shivashankar089/traffic-signal-controller/docs/screenshots/05_openlane_stage_by_stage/README.md

# OpenLane: Stage-by-Stage

This section follows the OpenLane implementation run from configuration through routing. The captures are from an interactive run using OpenLane v0.21 and the Sky130A PDK. The design configuration is tracked in [`physical_design/config.json`](../../../physical_design/config.json); the project's final signoff evidence is collected separately in [`06_signoff_and_gds/`](../06_signoff_and_gds/).

## Images

### Configuration and synthesis

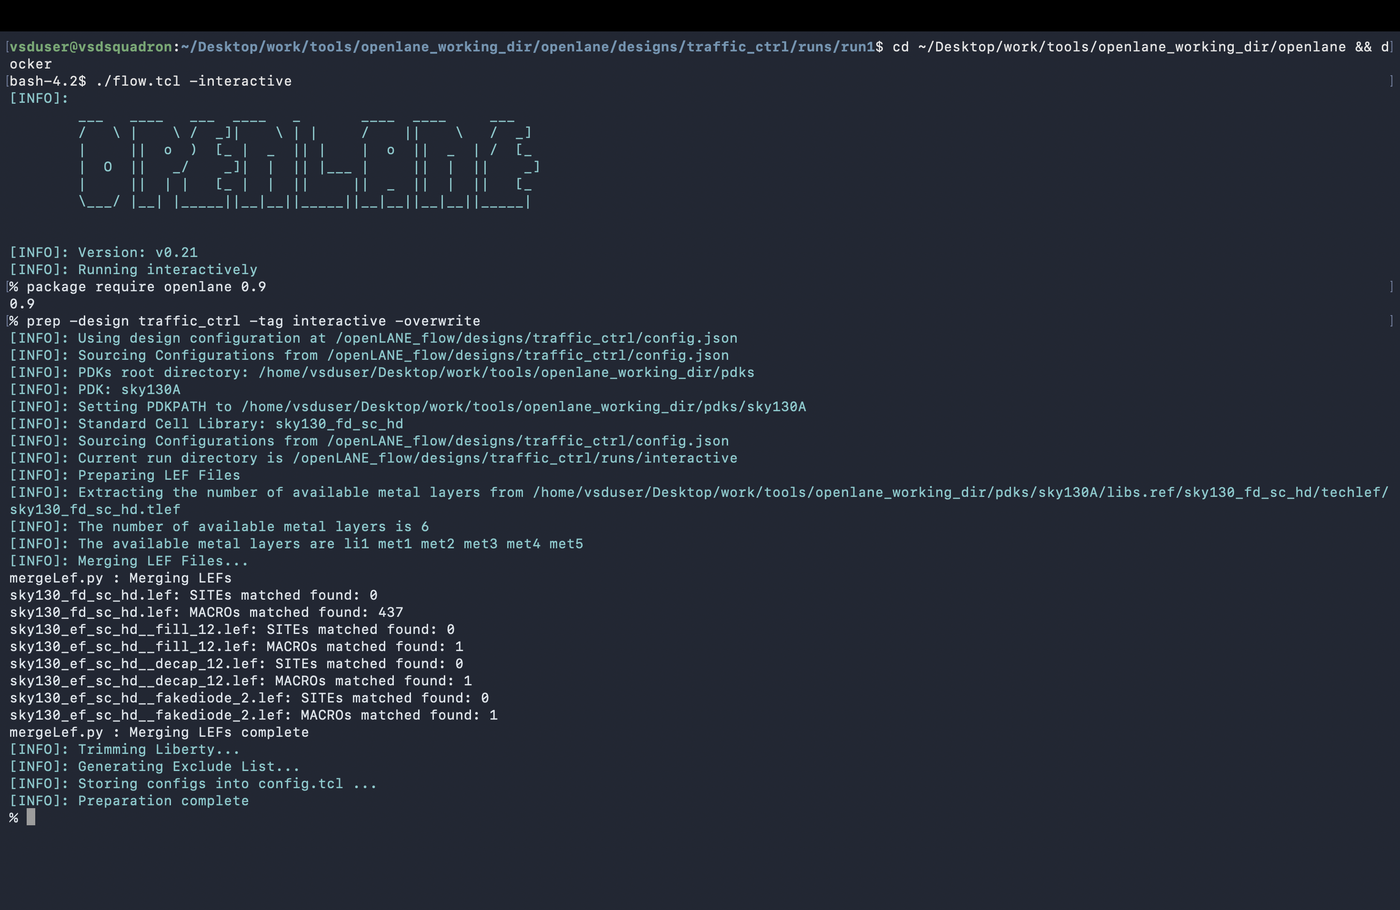
[picture p11: docs/screenshots/05_openlane_stage_by_stage/00_openlane_configuration.png]
OpenLane configuration and environment preparation


[`00_openlane_configuration.png`](00_openlane_configuration.png) shows OpenLane loading the `traffic_ctrl` configuration and preparing the Sky130 HD standard-cell library.

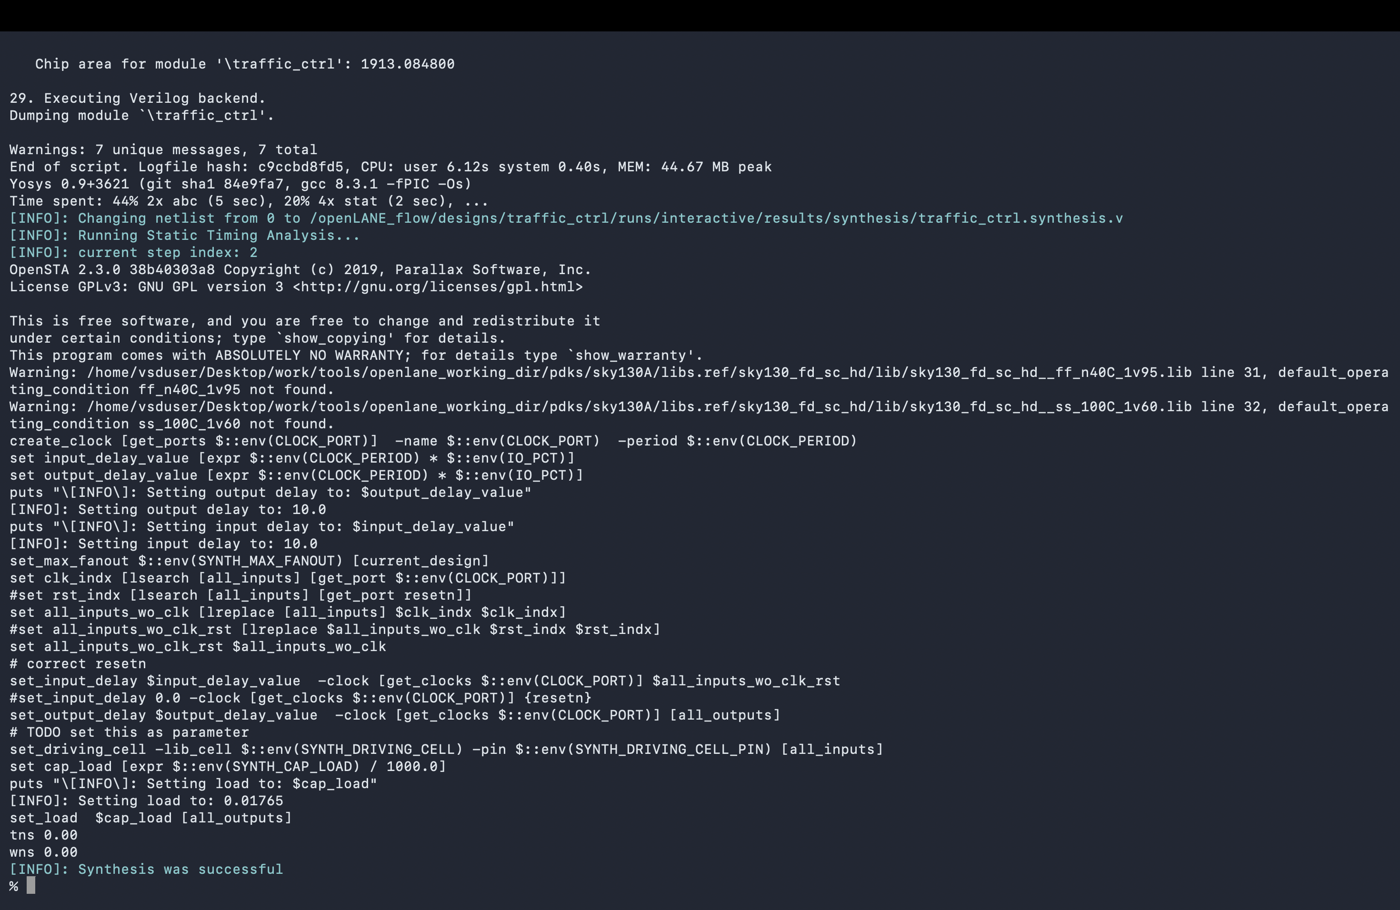
[picture p12: docs/screenshots/05_openlane_stage_by_stage/01_synthesis_successful.png]
Synthesis stage completed


[`01_synthesis_successful.png`](01_synthesis_successful.png) records successful completion of the synthesis stage.

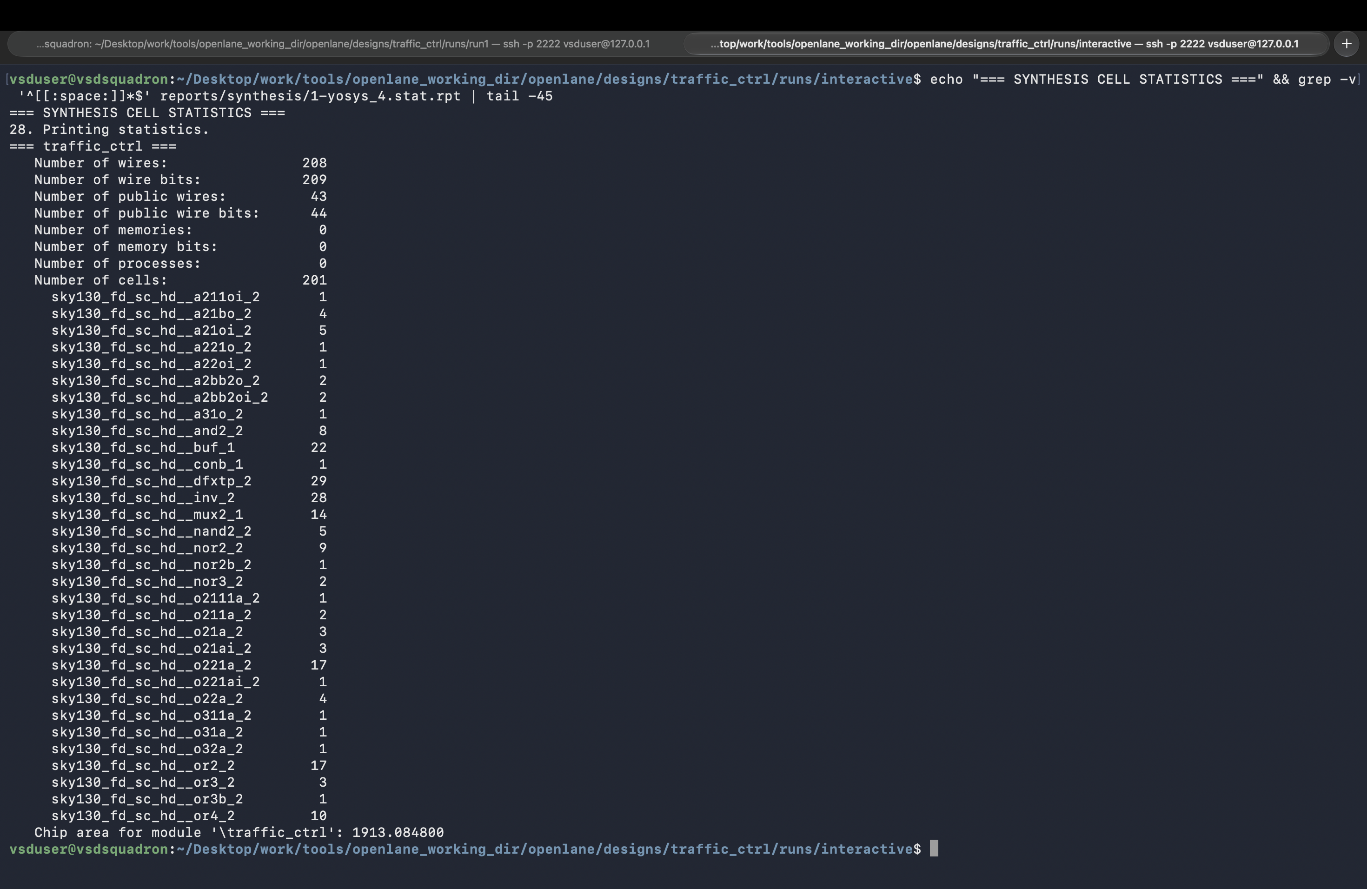
[picture p13: docs/screenshots/05_openlane_stage_by_stage/02_synthesis_stat_report.png]
Synthesis statistics


[`02_synthesis_stat_report.png`](02_synthesis_stat_report.png) shows the synthesis statistics report.

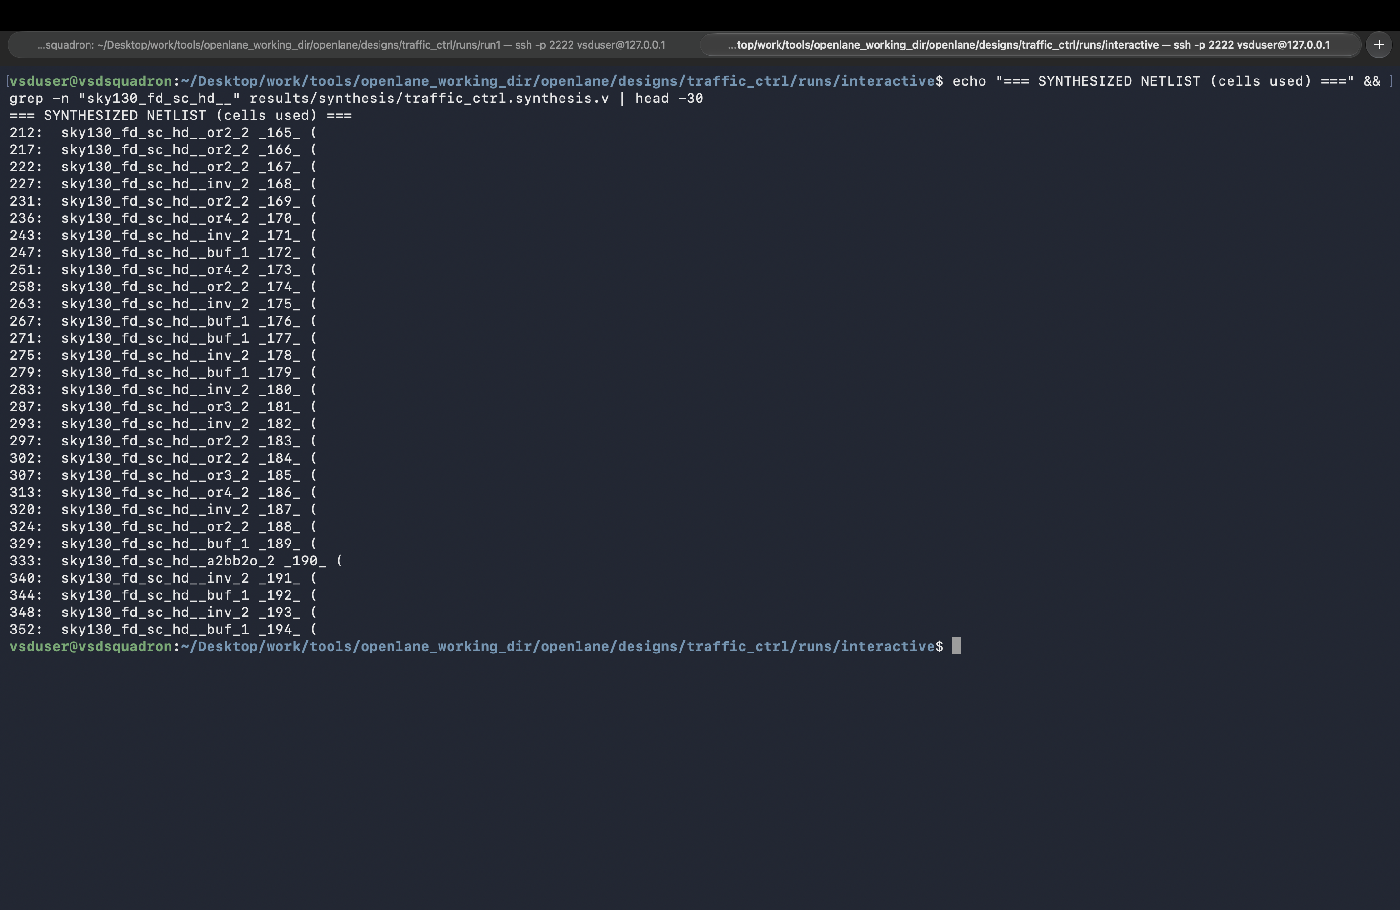
[picture p14: docs/screenshots/05_openlane_stage_by_stage/03_synthesis_netlist.png]
Synthesized netlist output


[`03_synthesis_netlist.png`](03_synthesis_netlist.png) shows the generated synthesis netlist artifact.

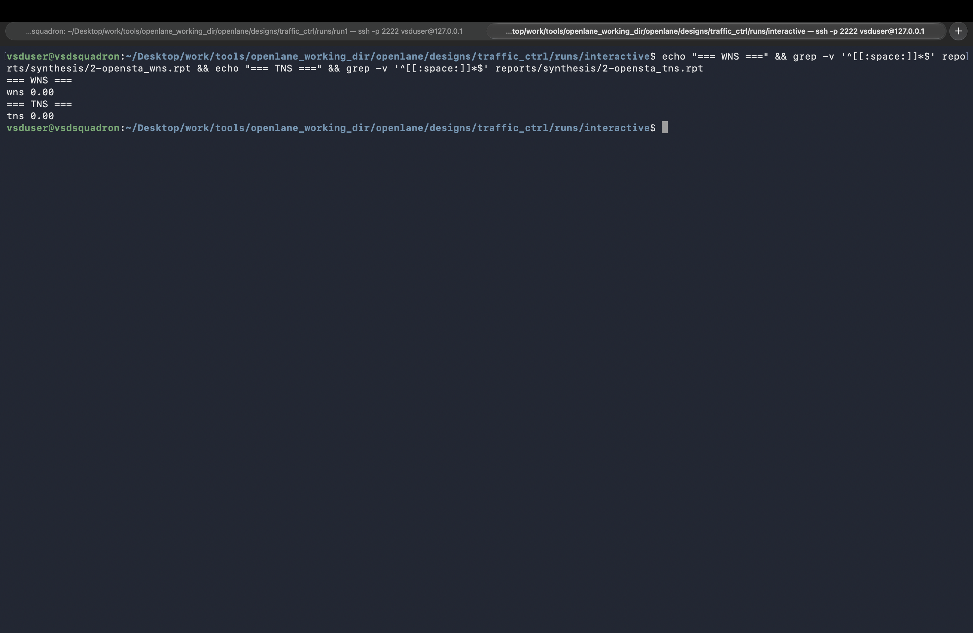
[picture p15: docs/screenshots/05_openlane_stage_by_stage/04_synthesis_sta.png]
Synthesis timing report


[`04_synthesis_sta.png`](04_synthesis_sta.png) shows timing analysis at the synthesis stage.

### Floorplanning

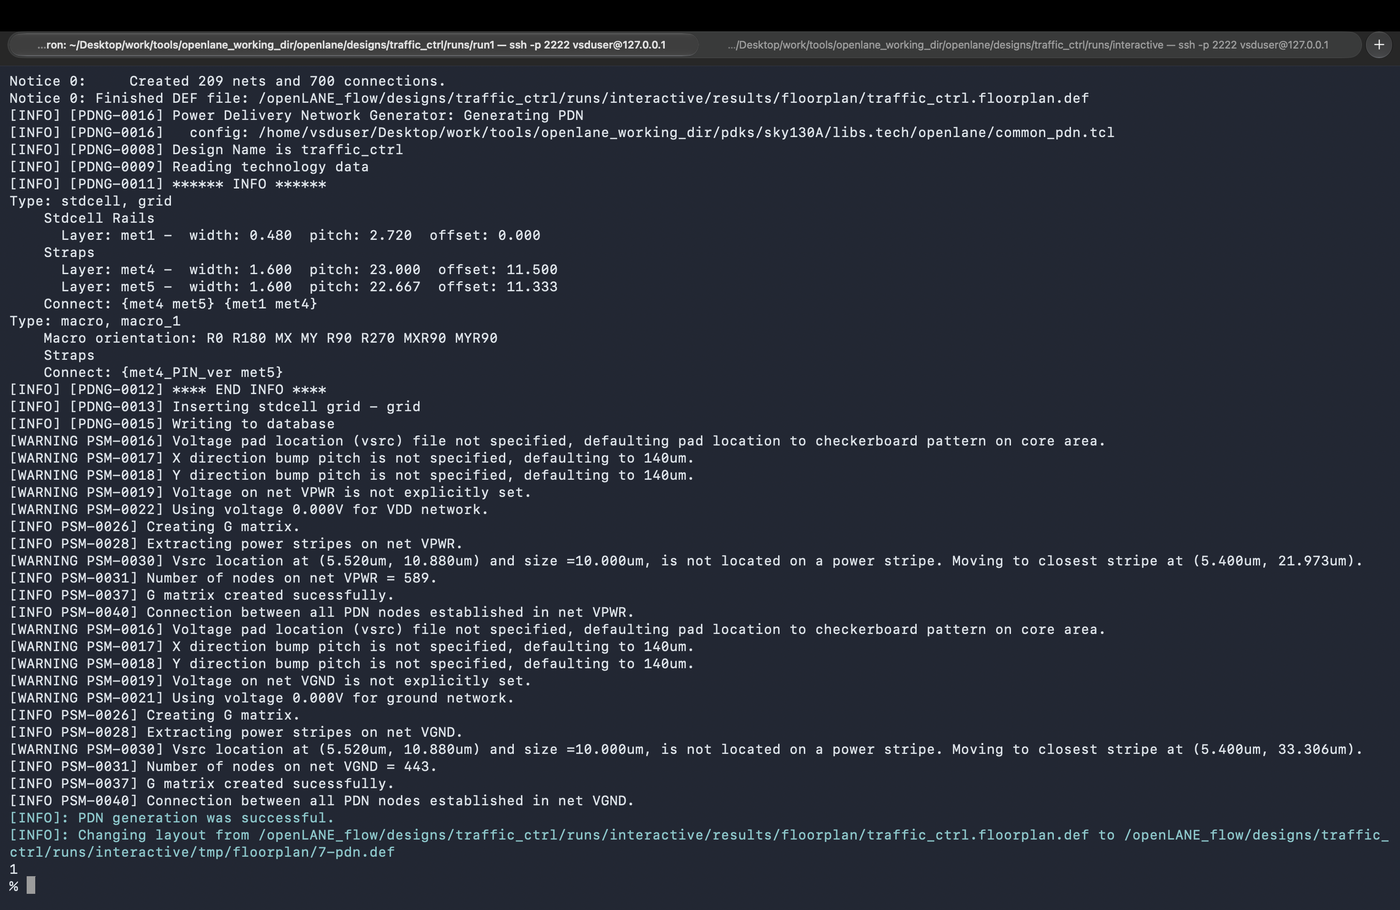
[picture p16: docs/screenshots/05_openlane_stage_by_stage/05_floorplan_successful.png]
Floorplan stage completed


[`05_floorplan_successful.png`](05_floorplan_successful.png) records successful floorplanning.

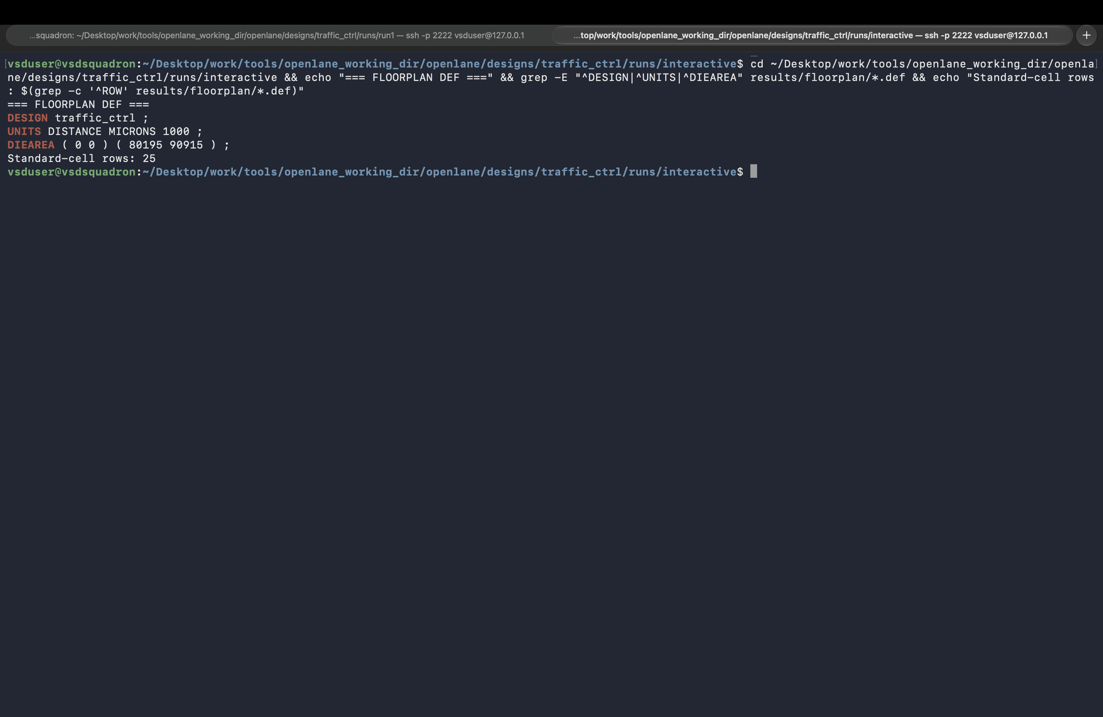
[picture p17: docs/screenshots/05_openlane_stage_by_stage/06_floorplan_def.png]
Floorplan DEF


[`06_floorplan_def.png`](06_floorplan_def.png) shows the floorplan represented in DEF.

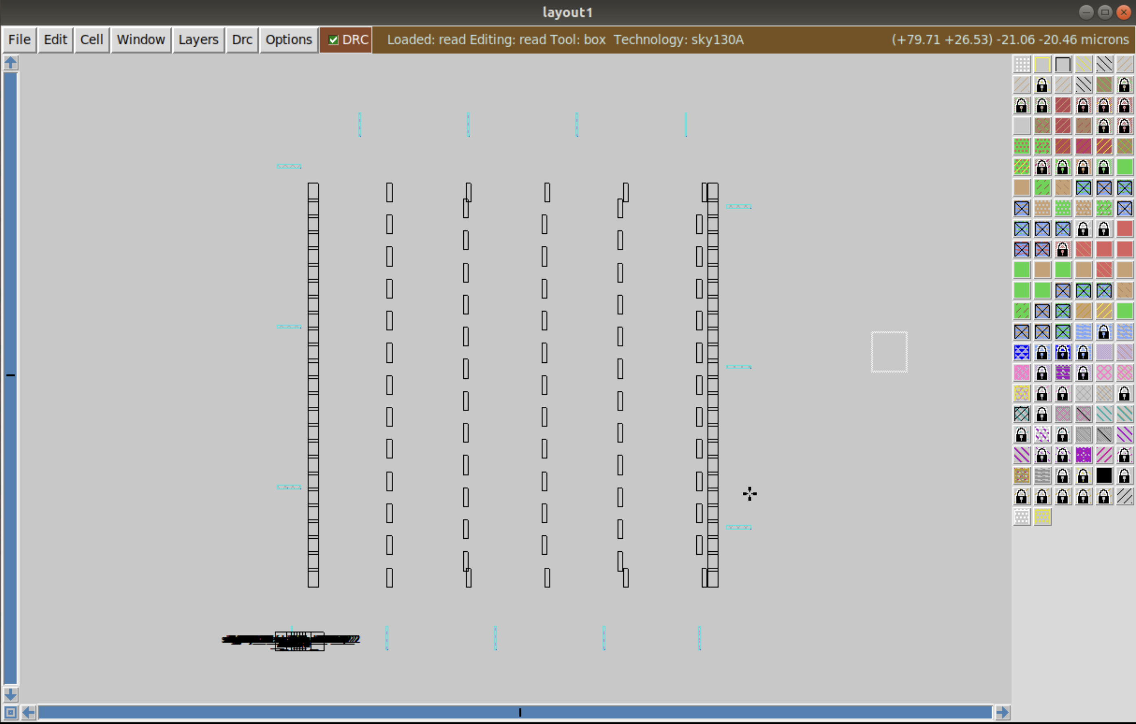
[picture p18: docs/screenshots/05_openlane_stage_by_stage/07_floorplan_magic.png]
Floorplan viewed in Magic


[`07_floorplan_magic.png`](07_floorplan_magic.png) shows the floorplan in the Magic layout viewer.

### Placement

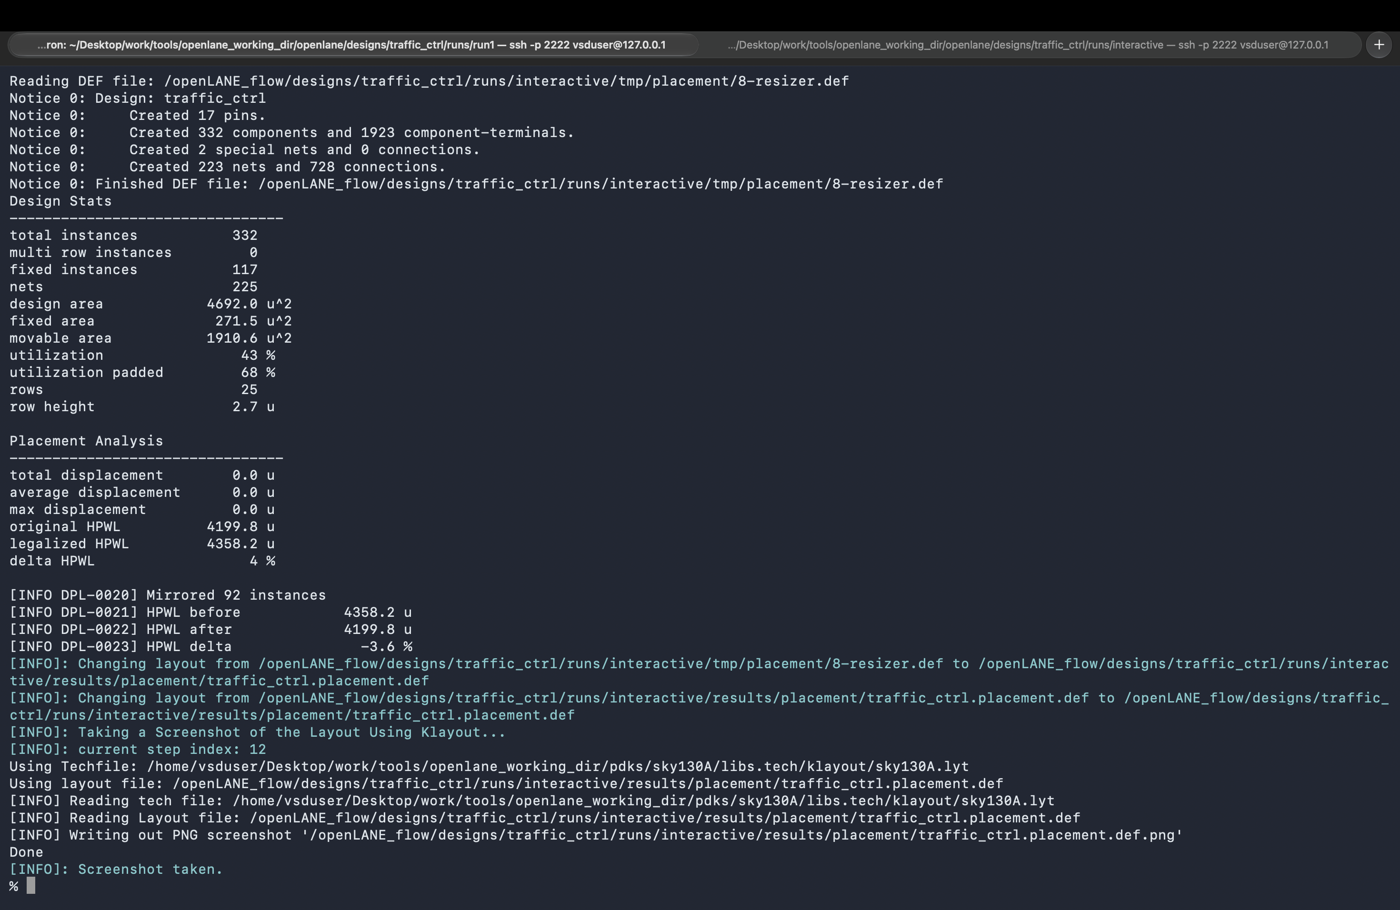
[picture p19: docs/screenshots/05_openlane_stage_by_stage/08_placement_completed.png]
Placement completed


[`08_placement_completed.png`](08_placement_completed.png) records completion of standard-cell placement.

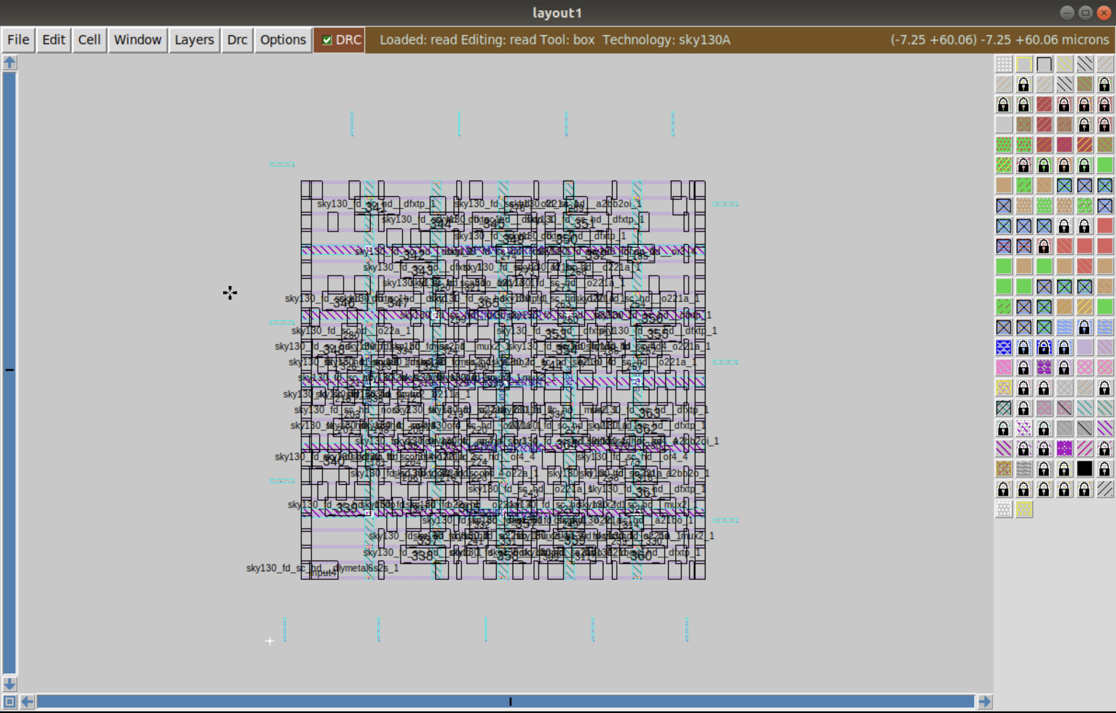
[picture p20: docs/screenshots/05_openlane_stage_by_stage/09_placement_magic.png]
Placed layout viewed in Magic


[`09_placement_magic.png`](09_placement_magic.png) shows the placed design in Magic.

### Clock-tree synthesis

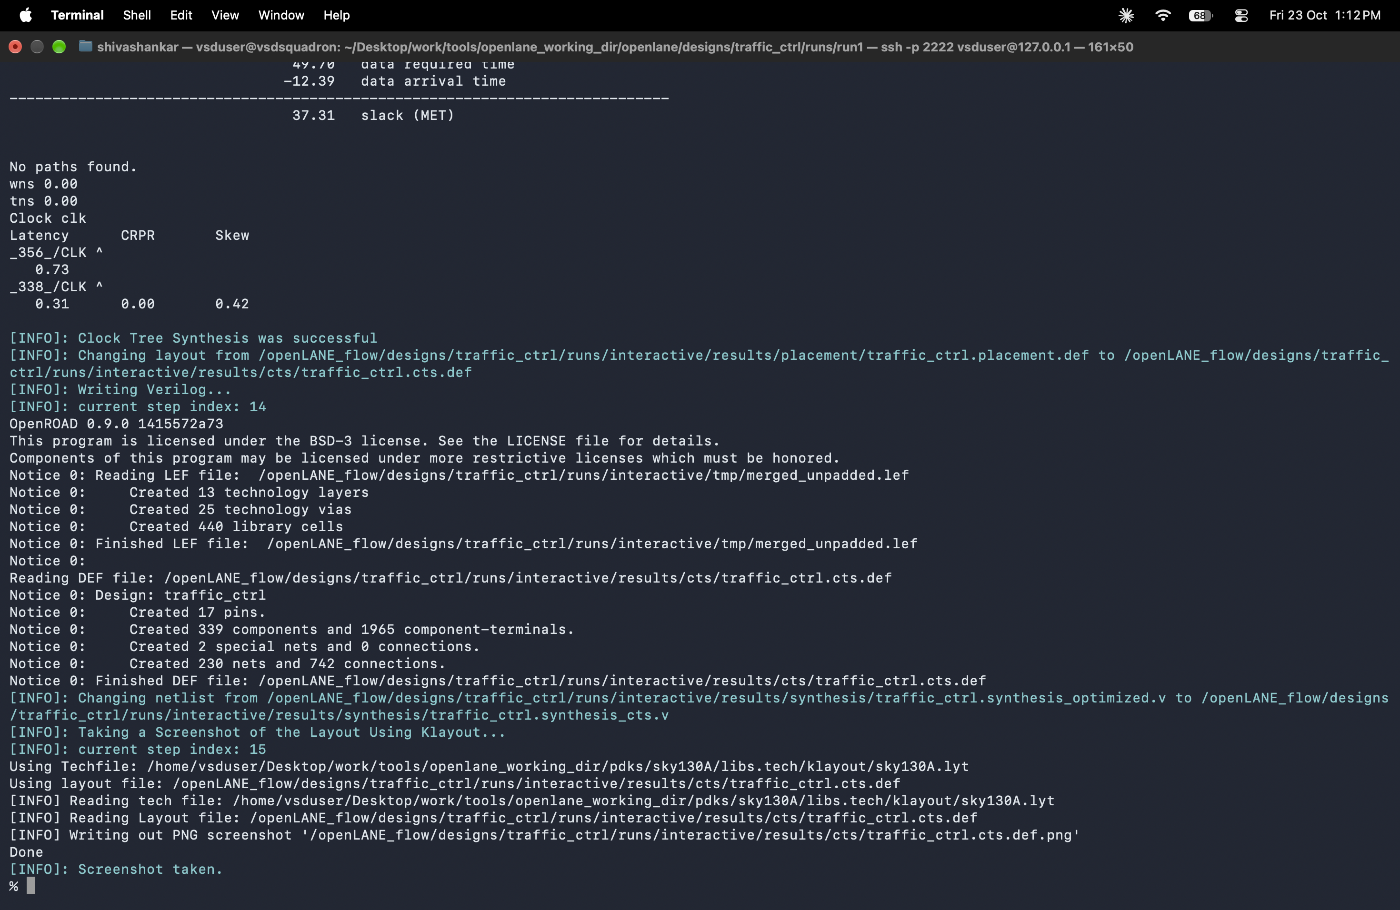
[picture p21: docs/screenshots/05_openlane_stage_by_stage/10_cts_run_successful.png]
Clock-tree synthesis completed


[`10_cts_run_successful.png`](10_cts_run_successful.png) records successful completion of clock-tree synthesis (CTS).

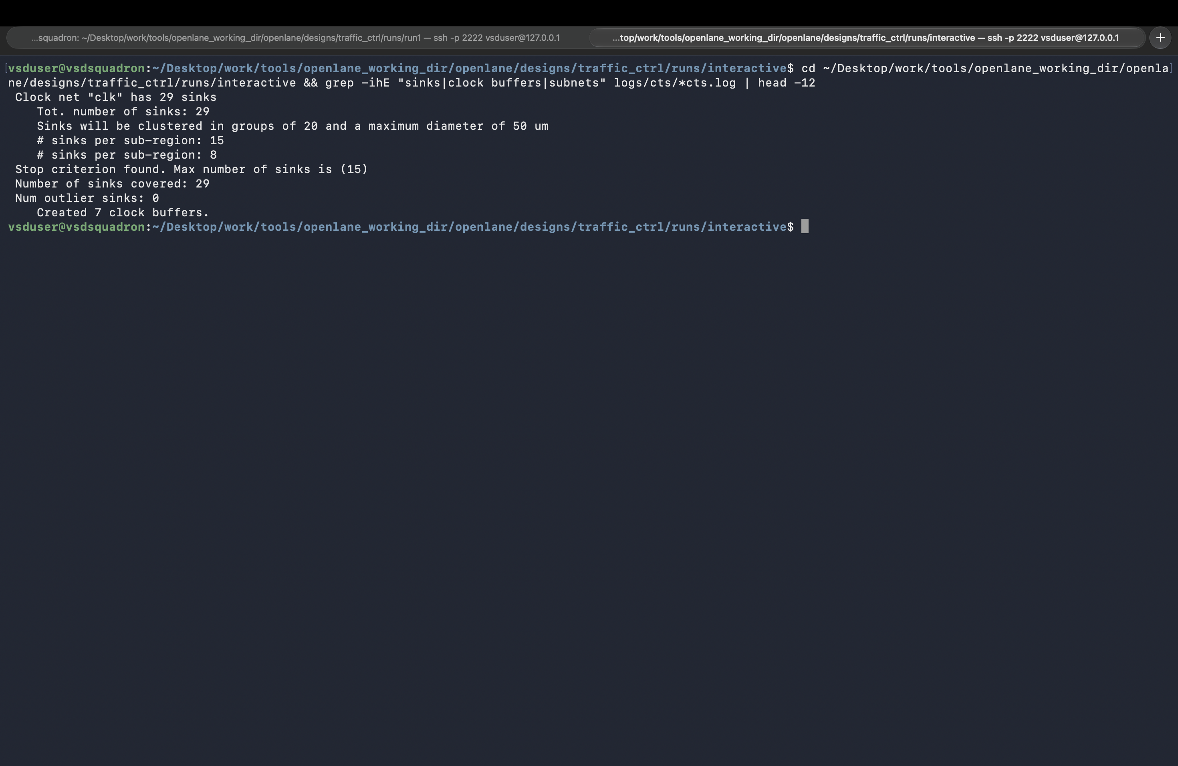
[picture p22: docs/screenshots/05_openlane_stage_by_stage/11_cts_stats.png]
Clock-tree synthesis statistics


[`11_cts_stats.png`](11_cts_stats.png) shows CTS-related statistics.

### Routing

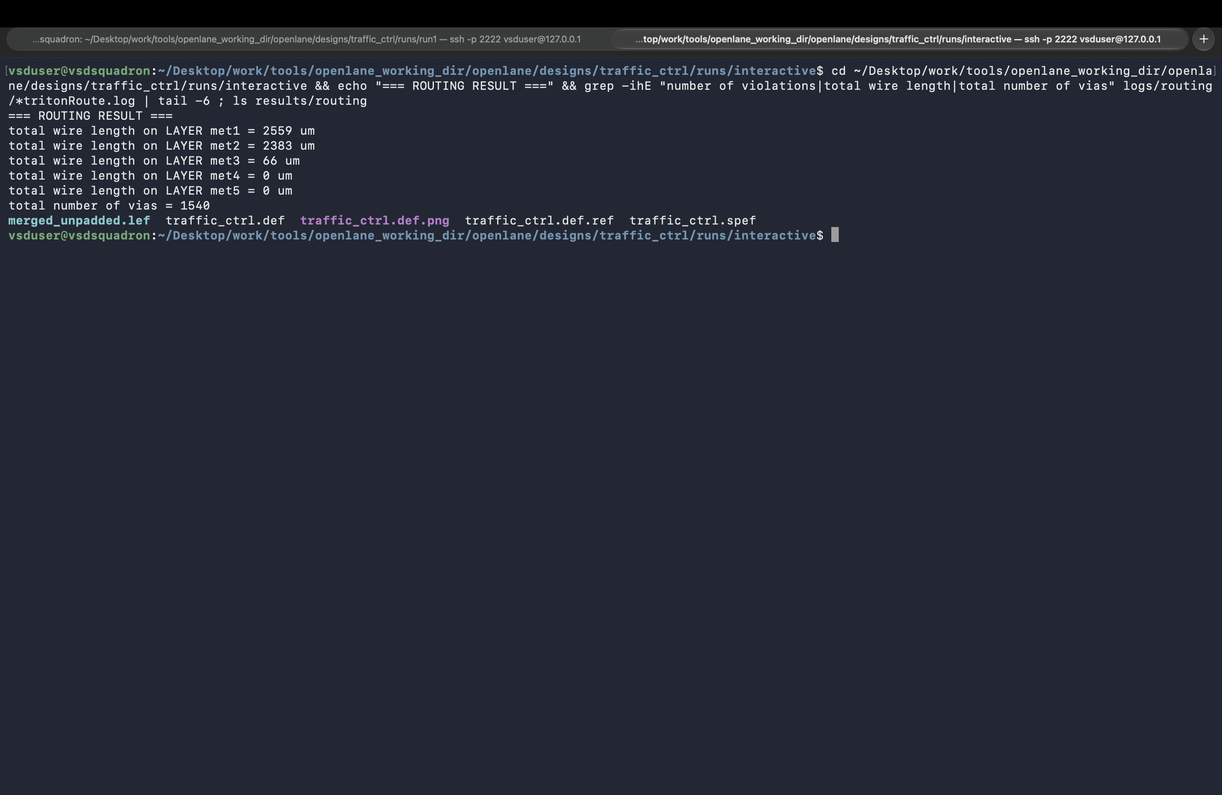
[picture p23: docs/screenshots/05_openlane_stage_by_stage/12_routing_successful.png]
Routing completed


[`12_routing_successful.png`](12_routing_successful.png) records successful completion of routing.

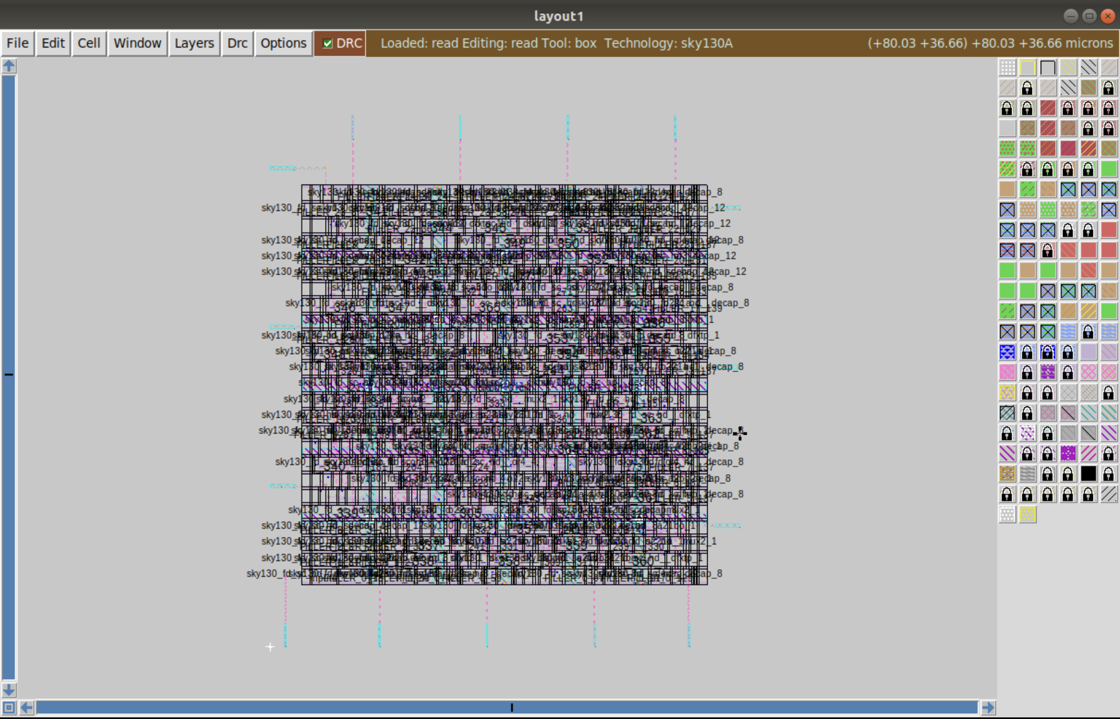
[picture p24: docs/screenshots/05_openlane_stage_by_stage/13_routing_magic_layout.png]
Routed layout viewed in Magic


[`13_routing_magic_layout.png`](13_routing_magic_layout.png) shows the routed layout in Magic.

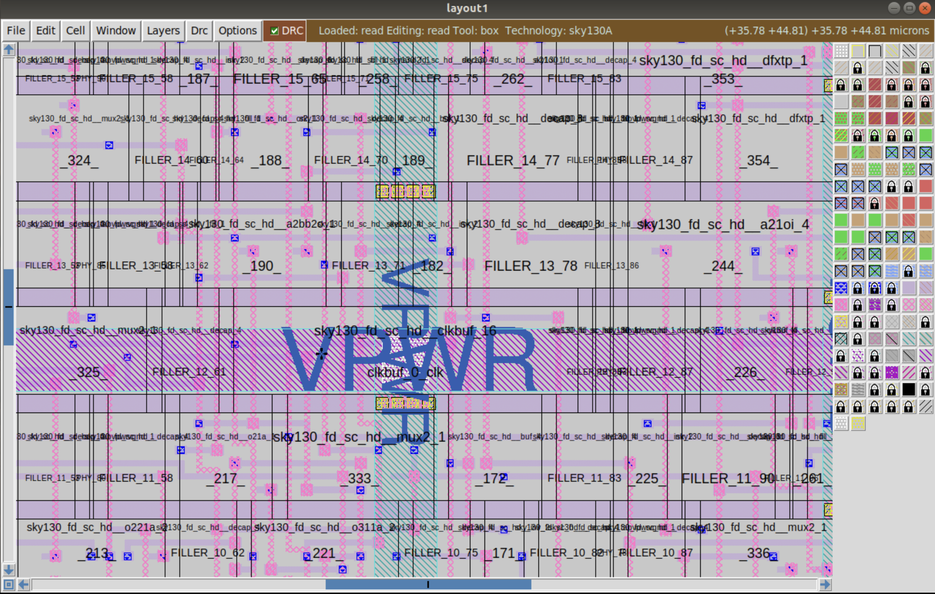
[picture p25: docs/screenshots/05_openlane_stage_by_stage/14_routing_magic_layout_zoom.png]
Zoomed routed layout


[`14_routing_magic_layout_zoom.png`](14_routing_magic_layout_zoom.png) provides a closer view of the routed layout.

## Scope

These images document intermediate stages, rather than serving as a complete signoff report. For the final GDS, DRC, LVS, antenna, area, and timing evidence, see [`06_signoff_and_gds/`](../06_signoff_and_gds/).
