shivashankar089/traffic-signal-controller/physical_design/reports/layout_pictures/traffic_ctrl.cts.def.png

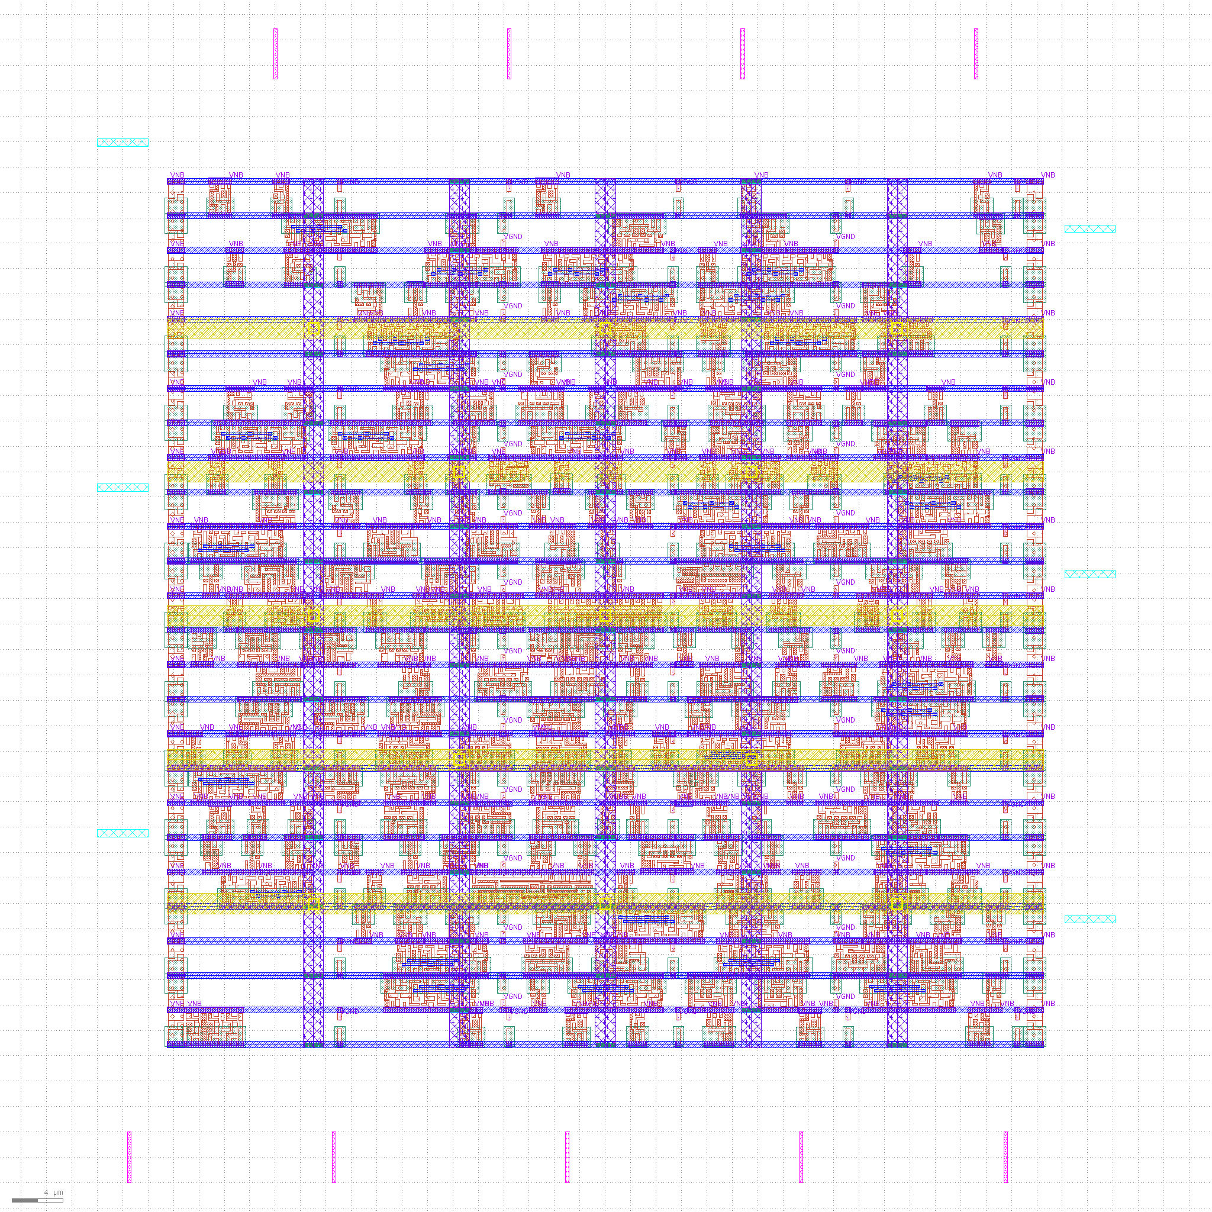
physical_design/reports/layout_pictures/traffic_ctrl.cts.def.png
