shivashankar089/traffic-signal-controller/physical_design/reports/layout_pictures/traffic_ctrl.floorplan.def.png

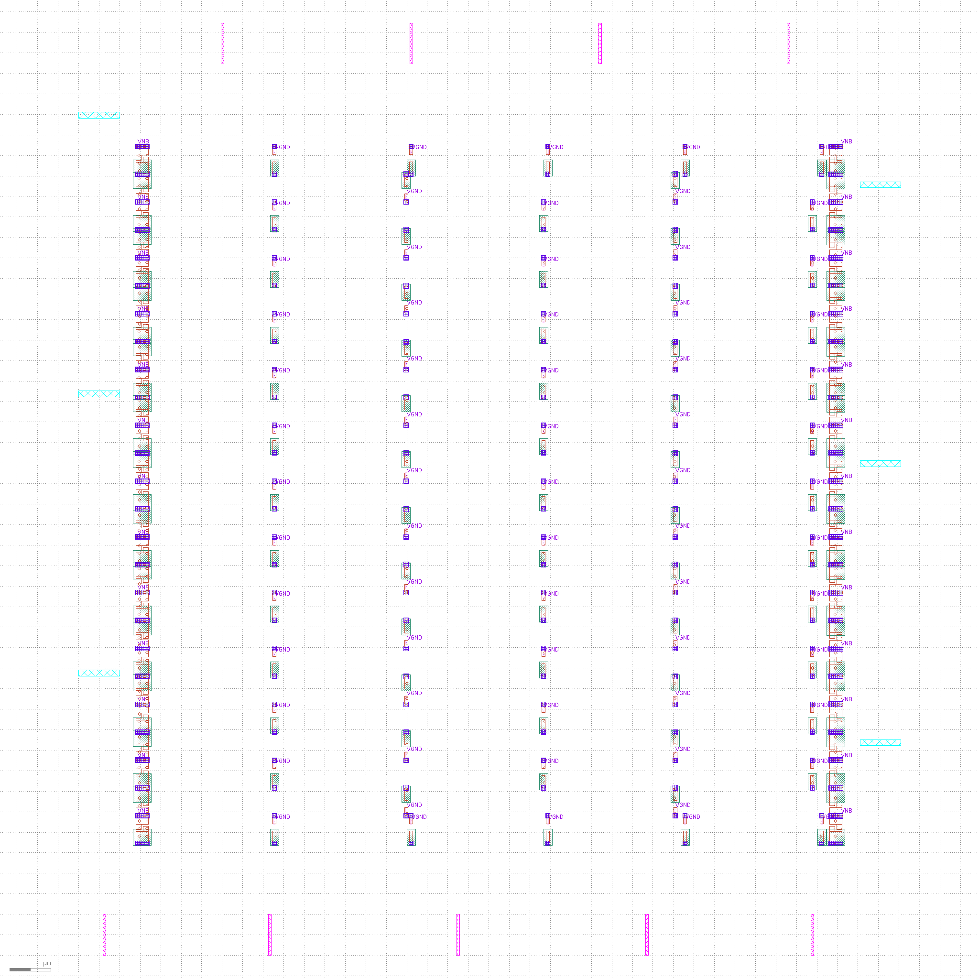
physical_design/reports/layout_pictures/traffic_ctrl.floorplan.def.png
