shivashankar089/traffic-signal-controller/physical_design/reports/layout_pictures/traffic_ctrl.gds.png

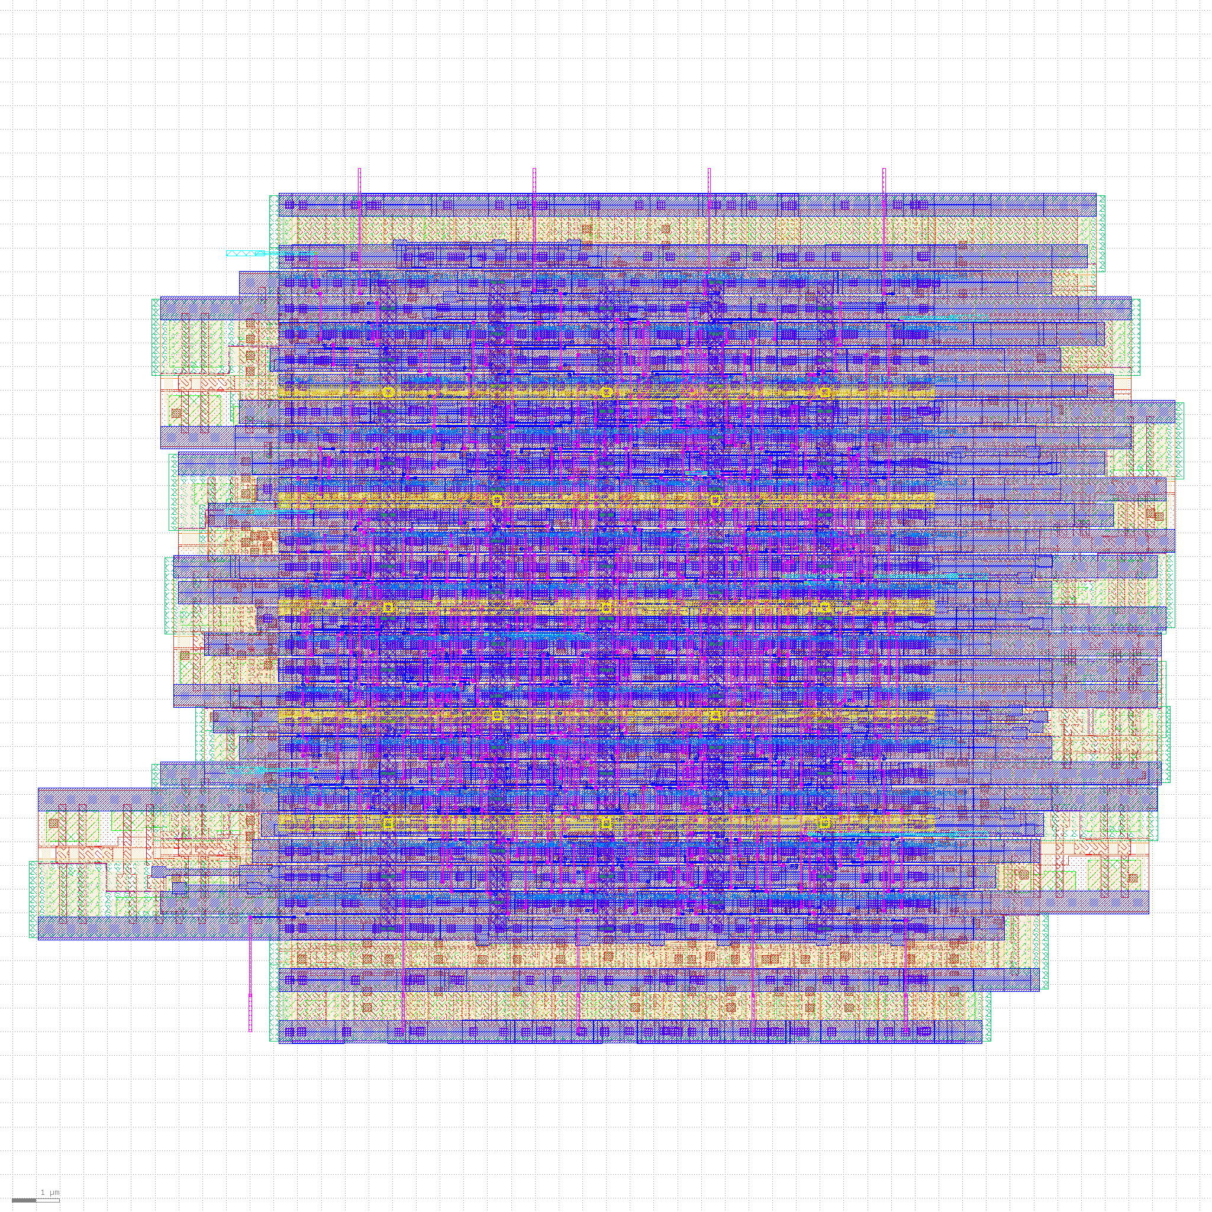
physical_design/reports/layout_pictures/traffic_ctrl.gds.png
