shivashankar089/traffic-signal-controller/physical_design/reports/summary/final_summary_report.csv

 | design | design_name | config | flow_status | total_runtime | routed_runtime | (Cell/mm^2)/Core_Util | DIEAREA_mm^2 | CellPer_mm^2 | OpenDP_Util | Peak_Memory_Usage_MB | cell_count | tritonRoute_violations | Short_violations | MetSpc_violations | OffGrid_violations | MinHole_violations | Other_violations | Magic_violations | antenna_violations | lvs_total_errors | cvc_total_errors | klayout_violations | wire_length | vias | wns | pl_wns | optimized_wns | fastroute_wns | spef_wns | tns | pl_tns | optimized_tns | fastroute_tns | spef_tns | HPWL | routing_layer1_pct | routing_layer2_pct | routing_layer3_pct | routing_layer4_pct | routing_layer5_pct | routing_layer6_pct | wires_count | wire_bits | public_wires_count | public_wire_bits | memories_count | memory_bits | processes_count | cells_pre_abc | AND | DFF | NAND | NOR | OR | XOR | XNOR | MUX | inputs
0 | /openLANE_flow/designs/traffic_ctrl | traffic_ctrl | run1 | Flow_completed | 0h19m22s | 0h17m45s | 69791.66666666667 | 0.0072 | 27916.66666666667 | 43 | 416.66 | 201 | 0 | 0 | 0 | 0 | 0 | 0 | 0 | 0 | 0 | 0 | -1 | 5265 | 1547 | 0.0 | 0.0 | 0.0 | 0.0 | 0.0 | 0.0 | 0.0 | 0.0 | 0.0 | 0.0 | 3076923 | 0.0 | 17.98 | 16.96 | 0.0 | 0.0 | 0.0 | 208 | 209 | 43 | 44 | 0 | 0 | 0 | 201 | 4 | 0 | 10 | 21 | 73 | 15 | 3 | 47 | 50
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
