shivashankar089/traffic-signal-controller/physical_design/results/netlist/traffic_ctrl.lvs.powered.v

module traffic_ctrl (a_green,
    a_red,
    a_yellow,
    b_green,
    b_red,
    b_yellow,
    clk,
    emg_a,
    emg_b,
    ped_req,
    ped_walk,
    reset,
    tick,
    VPWR,
    VGND,
    timing_sel);
 output a_green;
 output a_red;
 output a_yellow;
 output b_green;
 output b_red;
 output b_yellow;
 input clk;
 input emg_a;
 input emg_b;
 input ped_req;
 output ped_walk;
 input reset;
 input tick;
 input VPWR;
 input VGND;
 input [1:0] timing_sel;

 sky130_fd_sc_hd__or2_1 _165_ (.A(\cnt[1] ),
    .B(\cnt[0] ),
    .X(_066_),
    .VGND(VGND),
    .VNB(VGND),
    .VPB(VPWR),
    .VPWR(VPWR));
 sky130_fd_sc_hd__or2_1 _166_ (.A(\cnt[2] ),
    .B(_066_),
    .X(_067_),
    .VGND(VGND),
    .VNB(VGND),
    .VPB(VPWR),
    .VPWR(VPWR));
 sky130_fd_sc_hd__or2_2 _167_ (.A(\cnt[3] ),
    .B(_067_),
    .X(_068_),
    .VGND(VGND),
    .VNB(VGND),
    .VPB(VPWR),
    .VPWR(VPWR));
 sky130_fd_sc_hd__inv_2 _168_ (.A(net5),
    .Y(_069_),
    .VGND(VGND),
    .VNB(VGND),
    .VPB(VPWR),
    .VPWR(VPWR));
 sky130_fd_sc_hd__or2_1 _169_ (.A(\cnt[7] ),
    .B(\cnt[6] ),
    .X(_070_),
    .VGND(VGND),
    .VNB(VGND),
    .VPB(VPWR),
    .VPWR(VPWR));
 sky130_fd_sc_hd__or4_4 _170_ (.A(\cnt[5] ),
    .B(\cnt[4] ),
    .C(_070_),
    .D(_068_),
    .X(_071_),
    .VGND(VGND),
    .VNB(VGND),
    .VPB(VPWR),
    .VPWR(VPWR));
 sky130_fd_sc_hd__inv_2 _171_ (.A(_071_),
    .Y(_072_),
    .VGND(VGND),
    .VNB(VGND),
    .VPB(VPWR),
    .VPWR(VPWR));
 sky130_fd_sc_hd__buf_4 _172_ (.A(_072_),
    .X(_028_),
    .VGND(VGND),
    .VNB(VGND),
    .VPB(VPWR),
    .VPWR(VPWR));
 sky130_fd_sc_hd__or4_4 _173_ (.A(\cnt[4] ),
    .B(_068_),
    .C(_069_),
    .D(_028_),
    .X(_073_),
    .VGND(VGND),
    .VNB(VGND),
    .VPB(VPWR),
    .VPWR(VPWR));
 sky130_fd_sc_hd__or2_2 _174_ (.A(\cnt[5] ),
    .B(_073_),
    .X(_074_),
    .VGND(VGND),
    .VNB(VGND),
    .VPB(VPWR),
    .VPWR(VPWR));
 sky130_fd_sc_hd__inv_2 _175_ (.A(net4),
    .Y(_075_),
    .VGND(VGND),
    .VNB(VGND),
    .VPB(VPWR),
    .VPWR(VPWR));
 sky130_fd_sc_hd__clkbuf_2 _176_ (.A(\state[3] ),
    .X(_076_),
    .VGND(VGND),
    .VNB(VGND),
    .VPB(VPWR),
    .VPWR(VPWR));
 sky130_fd_sc_hd__clkbuf_2 _177_ (.A(_076_),
    .X(_077_),
    .VGND(VGND),
    .VNB(VGND),
    .VPB(VPWR),
    .VPWR(VPWR));
 sky130_fd_sc_hd__inv_2 _178_ (.A(\state[2] ),
    .Y(_078_),
    .VGND(VGND),
    .VNB(VGND),
    .VPB(VPWR),
    .VPWR(VPWR));
 sky130_fd_sc_hd__buf_1 _179_ (.A(_078_),
    .X(_010_),
    .VGND(VGND),
    .VNB(VGND),
    .VPB(VPWR),
    .VPWR(VPWR));
 sky130_fd_sc_hd__inv_2 _180_ (.A(\state[1] ),
    .Y(_027_),
    .VGND(VGND),
    .VNB(VGND),
    .VPB(VPWR),
    .VPWR(VPWR));
 sky130_fd_sc_hd__or3_4 _181_ (.A(_078_),
    .B(\state[3] ),
    .C(_027_),
    .X(_079_),
    .VGND(VGND),
    .VNB(VGND),
    .VPB(VPWR),
    .VPWR(VPWR));
 sky130_fd_sc_hd__inv_2 _182_ (.A(emg_a_s),
    .Y(_080_),
    .VGND(VGND),
    .VNB(VGND),
    .VPB(VPWR),
    .VPWR(VPWR));
 sky130_fd_sc_hd__or2_1 _183_ (.A(\min_cnt[7] ),
    .B(\min_cnt[4] ),
    .X(_081_),
    .VGND(VGND),
    .VNB(VGND),
    .VPB(VPWR),
    .VPWR(VPWR));
 sky130_fd_sc_hd__or2_2 _184_ (.A(\min_cnt[1] ),
    .B(\min_cnt[0] ),
    .X(_082_),
    .VGND(VGND),
    .VNB(VGND),
    .VPB(VPWR),
    .VPWR(VPWR));
 sky130_fd_sc_hd__or3_4 _185_ (.A(\min_cnt[3] ),
    .B(\min_cnt[2] ),
    .C(_082_),
    .X(_083_),
    .VGND(VGND),
    .VNB(VGND),
    .VPB(VPWR),
    .VPWR(VPWR));
 sky130_fd_sc_hd__or4_4 _186_ (.A(\min_cnt[6] ),
    .B(\min_cnt[5] ),
    .C(_081_),
    .D(_083_),
    .X(_084_),
    .VGND(VGND),
    .VNB(VGND),
    .VPB(VPWR),
    .VPWR(VPWR));
 sky130_fd_sc_hd__inv_2 _187_ (.A(emg_b_s),
    .Y(_085_),
    .VGND(VGND),
    .VNB(VGND),
    .VPB(VPWR),
    .VPWR(VPWR));
 sky130_fd_sc_hd__or2_1 _188_ (.A(emg_a_s),
    .B(_085_),
    .X(_086_),
    .VGND(VGND),
    .VNB(VGND),
    .VPB(VPWR),
    .VPWR(VPWR));
 sky130_fd_sc_hd__buf_1 _189_ (.A(_086_),
    .X(_007_),
    .VGND(VGND),
    .VNB(VGND),
    .VPB(VPWR),
    .VPWR(VPWR));
 sky130_fd_sc_hd__a2bb2o_1 _190_ (.A1_N(_080_),
    .A2_N(_084_),
    .B1(_072_),
    .B2(_007_),
    .X(_087_),
    .VGND(VGND),
    .VNB(VGND),
    .VPB(VPWR),
    .VPWR(VPWR));
 sky130_fd_sc_hd__inv_2 _191_ (.A(_087_),
    .Y(_088_),
    .VGND(VGND),
    .VNB(VGND),
    .VPB(VPWR),
    .VPWR(VPWR));
 sky130_fd_sc_hd__clkbuf_2 _192_ (.A(\state[2] ),
    .X(_089_),
    .VGND(VGND),
    .VNB(VGND),
    .VPB(VPWR),
    .VPWR(VPWR));
 sky130_fd_sc_hd__inv_2 _193_ (.A(\state[0] ),
    .Y(_090_),
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
 sky130_fd_sc_hd__decap_8 FILLER_24_129 (.VGND(VGND),
    .VNB(VGND),
    .VPB(VPWR),
    .VPWR(VPWR));
 sky130_fd_sc_hd__fill_1 FILLER_24_137 (.VGND(VGND),
    .VNB(VGND),
    .VPB(VPWR),
    .VPWR(VPWR));
 sky130_fd_sc_hd__decap_4 FILLER_24_141 (.VGND(VGND),
    .VNB(VGND),
    .VPB(VPWR),
    .VPWR(VPWR));
 sky130_fd_sc_hd__fill_1 FILLER_24_146 (.VGND(VGND),
    .VNB(VGND),
    .VPB(VPWR),
    .VPWR(VPWR));
endmodule
