shivashankar089/traffic-signal-controller/physical_design/results/netlist/traffic_ctrl.synthesis_cts.v

module traffic_ctrl (a_green,
    a_red,
    a_yellow,
    b_green,
    b_red,
    b_yellow,
    clk,
    emg_a,
    emg_b,
    ped_req,
    ped_walk,
    reset,
    tick,
    VPWR,
    VGND,
    timing_sel);
 output a_green;
 output a_red;
 output a_yellow;
 output b_green;
 output b_red;
 output b_yellow;
 input clk;
 input emg_a;
 input emg_b;
 input ped_req;
 output ped_walk;
 input reset;
 input tick;
 input VPWR;
 input VGND;
 input [1:0] timing_sel;

 sky130_fd_sc_hd__or2_1 _165_ (.A(\cnt[1] ),
    .B(\cnt[0] ),
    .X(_066_));
 sky130_fd_sc_hd__or2_1 _166_ (.A(\cnt[2] ),
    .B(_066_),
    .X(_067_));
 sky130_fd_sc_hd__or2_2 _167_ (.A(\cnt[3] ),
    .B(_067_),
    .X(_068_));
 sky130_fd_sc_hd__inv_2 _168_ (.A(net5),
    .Y(_069_));
 sky130_fd_sc_hd__or2_1 _169_ (.A(\cnt[7] ),
    .B(\cnt[6] ),
    .X(_070_));
 sky130_fd_sc_hd__or4_4 _170_ (.A(\cnt[5] ),
    .B(\cnt[4] ),
    .C(_070_),
    .D(_068_),
    .X(_071_));
 sky130_fd_sc_hd__inv_2 _171_ (.A(_071_),
    .Y(_072_));
 sky130_fd_sc_hd__buf_4 _172_ (.A(_072_),
    .X(_028_));
 sky130_fd_sc_hd__or4_4 _173_ (.A(\cnt[4] ),
    .B(_068_),
    .C(_069_),
    .D(_028_),
    .X(_073_));
 sky130_fd_sc_hd__or2_2 _174_ (.A(\cnt[5] ),
    .B(_073_),
    .X(_074_));
 sky130_fd_sc_hd__inv_2 _175_ (.A(net4),
    .Y(_075_));
 sky130_fd_sc_hd__clkbuf_2 _176_ (.A(\state[3] ),
    .X(_076_));
 sky130_fd_sc_hd__clkbuf_2 _177_ (.A(_076_),
    .X(_077_));
 sky130_fd_sc_hd__inv_2 _178_ (.A(\state[2] ),
    .Y(_078_));
 sky130_fd_sc_hd__buf_1 _179_ (.A(_078_),
    .X(_010_));
 sky130_fd_sc_hd__inv_2 _180_ (.A(\state[1] ),
    .Y(_027_));
 sky130_fd_sc_hd__or3_4 _181_ (.A(_078_),
    .B(\state[3] ),
    .C(_027_),
    .X(_079_));
 sky130_fd_sc_hd__inv_2 _182_ (.A(emg_a_s),
    .Y(_080_));
 sky130_fd_sc_hd__or2_1 _183_ (.A(\min_cnt[7] ),
    .B(\min_cnt[4] ),
    .X(_081_));
 sky130_fd_sc_hd__or2_2 _184_ (.A(\min_cnt[1] ),
    .B(\min_cnt[0] ),
    .X(_082_));
 sky130_fd_sc_hd__or3_4 _185_ (.A(\min_cnt[3] ),
    .B(\min_cnt[2] ),
    .C(_082_),
    .X(_083_));
 sky130_fd_sc_hd__or4_4 _186_ (.A(\min_cnt[6] ),
    .B(\min_cnt[5] ),
    .C(_081_),
    .D(_083_),
    .X(_084_));
 sky130_fd_sc_hd__inv_2 _187_ (.A(emg_b_s),
    .Y(_085_));
 sky130_fd_sc_hd__or2_1 _188_ (.A(emg_a_s),
    .B(_085_),
    .X(_086_));
 sky130_fd_sc_hd__buf_1 _189_ (.A(_086_),
    .X(_007_));
 sky130_fd_sc_hd__a2bb2o_1 _190_ (.A1_N(_080_),
    .A2_N(_084_),
    .B1(_072_),
    .B2(_007_),
    .X(_087_));
 sky130_fd_sc_hd__inv_2 _191_ (.A(_087_),
    .Y(_088_));
 sky130_fd_sc_hd__clkbuf_2 _192_ (.A(\state[2] ),
    .X(_089_));
 sky130_fd_sc_hd__inv_2 _193_ (.A(\state[0] ),
    .Y(_090_));
 sky130_fd_sc_hd__clkbuf_2 _194_ (.A(_090_),
    .X(_004_));
 sky130_fd_sc_hd__or4_4 _195_ (.A(_089_),
    .B(_077_),
    .C(_004_),
    .D(_027_),
    .X(_091_));
 sky130_fd_sc_hd__buf_1 _196_ (.A(\state[0] ),
    .X(_092_));
 sky130_fd_sc_hd__clkbuf_2 _197_ (.A(\state[1] ),
    .X(_093_));
 sky130_fd_sc_hd__or4_4 _198_ (.A(_092_),
    .B(_093_),
    .C(_010_),
    .D(_076_),
    .X(_094_));
 sky130_fd_sc_hd__inv_2 _199_ (.A(_094_),
    .Y(net13));
 sky130_fd_sc_hd__or4_4 _200_ (.A(_089_),
    .B(_076_),
    .C(_092_),
    .D(_027_),
    .X(_095_));
 sky130_fd_sc_hd__or4_4 _201_ (.A(_010_),
    .B(_076_),
    .C(_090_),
    .D(_093_),
    .X(_096_));
 sky130_fd_sc_hd__a21oi_1 _202_ (.A1(_095_),
    .A2(_096_),
    .B1(_012_),
    .Y(_097_));
 sky130_fd_sc_hd__nor3_2 _203_ (.A(_077_),
    .B(net13),
    .C(_097_),
    .Y(_098_));
 sky130_fd_sc_hd__o221a_2 _204_ (.A1(_028_),
    .A2(_079_),
    .B1(_088_),
    .B2(_091_),
    .C1(_098_),
    .X(_099_));
 sky130_fd_sc_hd__inv_2 _205_ (.A(_099_),
    .Y(_100_));
 sky130_fd_sc_hd__o22a_1 _206_ (.A1(_010_),
    .A2(_099_),
    .B1(_089_),
    .B2(_100_),
    .X(_101_));
 sky130_fd_sc_hd__or2_1 _207_ (.A(_087_),
    .B(_091_),
    .X(_102_));
 sky130_fd_sc_hd__or2_2 _208_ (.A(_092_),
    .B(_079_),
    .X(_103_));
 sky130_fd_sc_hd__or4_4 _209_ (.A(_089_),
    .B(_077_),
    .C(_004_),
    .D(_093_),
    .X(_104_));
 sky130_fd_sc_hd__inv_2 _210_ (.A(_076_),
    .Y(_105_));
 sky130_fd_sc_hd__o32a_1 _211_ (.A1(_004_),
    .A2(_029_),
    .A3(_079_),
    .B1(_001_),
    .B2(_096_),
    .X(_106_));
 sky130_fd_sc_hd__o211a_1 _212_ (.A1(_003_),
    .A2(_095_),
    .B1(_105_),
    .C1(_106_),
    .X(_107_));
 sky130_fd_sc_hd__o221a_2 _213_ (.A1(_031_),
    .A2(_103_),
    .B1(_071_),
    .B2(_104_),
    .C1(_107_),
    .X(_108_));
 sky130_fd_sc_hd__nand2_2 _214_ (.A(_102_),
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
    .B(_117_),
    .X(_037_));
 sky130_fd_sc_hd__inv_2 _293_ (.A(_103_),
    .Y(net14));
 sky130_fd_sc_hd__inv_2 _294_ (.A(_091_),
    .Y(net11));
 sky130_fd_sc_hd__inv_2 _295_ (.A(_104_),
    .Y(net10));
 sky130_fd_sc_hd__inv_2 _296_ (.A(_111_),
    .Y(net8));
 sky130_fd_sc_hd__nor2_1 _297_ (.A(net8),
    .B(net10),
    .Y(net9));
 sky130_fd_sc_hd__o21ai_1 _298_ (.A1(resume_b),
    .A2(emg_b_s),
    .B1(_080_),
    .Y(_030_));
 sky130_fd_sc_hd__or3b_2 _299_ (.A(emg_b_s),
    .B(emg_a_s),
    .C_N(ped_pending),
    .X(_160_));
 sky130_fd_sc_hd__buf_1 _300_ (.A(_160_),
    .X(_011_));
 sky130_fd_sc_hd__and2_1 _301_ (.A(_007_),
    .B(_011_),
    .X(_000_));
 sky130_fd_sc_hd__clkbuf_1 _302_ (.A(emg_a_s),
    .X(_002_));
 sky130_fd_sc_hd__nand2_1 _303_ (.A(_080_),
    .B(_011_),
    .Y(_008_));
 sky130_fd_sc_hd__nor2_1 _304_ (.A(_069_),
    .B(_084_),
    .Y(_013_));
 sky130_fd_sc_hd__o221ai_4 _305_ (.A1(_117_),
    .A2(_108_),
    .B1(_116_),
    .B2(_109_),
    .C1(_099_),
    .Y(_015_));
 sky130_fd_sc_hd__inv_2 _306_ (.A(\cnt[0] ),
    .Y(_017_));
 sky130_fd_sc_hd__o22a_1 _307_ (.A1(_117_),
    .A2(_099_),
    .B1(_116_),
    .B2(_100_),
    .X(_161_));
 sky130_fd_sc_hd__nor2_1 _308_ (.A(_109_),
    .B(_161_),
    .Y(_018_));
 sky130_fd_sc_hd__a21bo_1 _309_ (.A1(\cnt[1] ),
    .A2(\cnt[0] ),
    .B1_N(_066_),
    .X(_019_));
 sky130_fd_sc_hd__clkbuf_1 _310_ (.A(_015_),
    .X(_020_));
 sky130_fd_sc_hd__a21bo_1 _311_ (.A1(\cnt[2] ),
    .A2(_066_),
    .B1_N(_067_),
    .X(_021_));
 sky130_fd_sc_hd__inv_2 _312_ (.A(net6),
    .Y(_162_));
 sky130_fd_sc_hd__o21ai_1 _313_ (.A1(_162_),
    .A2(_015_),
    .B1(_155_),
    .Y(_022_));
 sky130_fd_sc_hd__a21bo_1 _314_ (.A1(\cnt[3] ),
    .A2(_067_),
    .B1_N(_068_),
    .X(_023_));
 sky130_fd_sc_hd__nor2_1 _315_ (.A(net7),
    .B(_015_),
    .Y(_024_));
 sky130_fd_sc_hd__a2bb2o_1 _316_ (.A1_N(\cnt[4] ),
    .A2_N(_068_),
    .B1(\cnt[4] ),
    .B2(_068_),
    .X(_025_));
 sky130_fd_sc_hd__nor2b_1 _317_ (.A(_015_),
    .B_N(net7),
    .Y(_026_));
 sky130_fd_sc_hd__nor2_1 _318_ (.A(net11),
    .B(net13),
    .Y(net12));
 sky130_fd_sc_hd__inv_2 _319_ (.A(ped_d),
    .Y(_163_));
 sky130_fd_sc_hd__a31o_1 _320_ (.A1(ped_s),
    .A2(_163_),
    .A3(_103_),
    .B1(ped_pending),
    .X(_164_));
 sky130_fd_sc_hd__o211a_1 _321_ (.A1(net14),
    .A2(_155_),
    .B1(_149_),
    .C1(_164_),
    .X(_065_));
 sky130_fd_sc_hd__conb_1 _322_ (.LO(_040_));
 sky130_fd_sc_hd__mux2_1 _323_ (.A0(_004_),
    .A1(_007_),
    .S(_028_),
    .X(_005_));
 sky130_fd_sc_hd__mux2_1 _324_ (.A0(_004_),
    .A1(_030_),
    .S(_028_),
    .X(_006_));
 sky130_fd_sc_hd__mux2_1 _325_ (.A0(_027_),
    .A1(_030_),
    .S(_028_),
    .X(_031_));
 sky130_fd_sc_hd__mux2_1 _326_ (.A0(_027_),
    .A1(_007_),
    .S(_028_),
    .X(_029_));
 sky130_fd_sc_hd__mux2_1 _327_ (.A0(_004_),
    .A1(_008_),
    .S(_028_),
    .X(_009_));
 sky130_fd_sc_hd__mux2_1 _328_ (.A0(_026_),
    .A1(_025_),
    .S(_014_),
    .X(_036_));
 sky130_fd_sc_hd__mux2_1 _329_ (.A0(_022_),
    .A1(_021_),
    .S(_014_),
    .X(_034_));
 sky130_fd_sc_hd__mux2_1 _330_ (.A0(_024_),
    .A1(_023_),
    .S(_014_),
    .X(_035_));
 sky130_fd_sc_hd__mux2_1 _331_ (.A0(_020_),
    .A1(_019_),
    .S(_014_),
    .X(_033_));
 sky130_fd_sc_hd__mux2_1 _332_ (.A0(_018_),
    .A1(_017_),
    .S(_014_),
    .X(_032_));
 sky130_fd_sc_hd__mux2_1 _333_ (.A0(_027_),
    .A1(_002_),
    .S(_028_),
    .X(_003_));
 sky130_fd_sc_hd__mux2_1 _334_ (.A0(_027_),
    .A1(_000_),
    .S(_028_),
    .X(_001_));
 sky130_fd_sc_hd__mux2_1 _335_ (.A0(_010_),
    .A1(_011_),
    .S(_028_),
    .X(_012_));
 sky130_fd_sc_hd__mux2_1 _336_ (.A0(_015_),
    .A1(_013_),
    .S(_014_),
    .X(_016_));
 sky130_fd_sc_hd__dfxtp_1 _337_ (.D(_037_),
    .Q(\state[0] ),
    .CLK(clknet_2_0_0_clk));
 sky130_fd_sc_hd__dfxtp_1 _338_ (.D(_038_),
    .Q(\state[1] ),
    .CLK(clknet_2_0_0_clk));
 sky130_fd_sc_hd__dfxtp_1 _339_ (.D(_039_),
    .Q(\state[2] ),
    .CLK(clknet_2_0_0_clk));
 sky130_fd_sc_hd__dfxtp_1 _340_ (.D(_040_),
    .Q(\state[3] ),
    .CLK(clknet_2_0_0_clk));
 sky130_fd_sc_hd__dfxtp_1 _341_ (.D(_041_),
    .Q(\sync_p[0] ),
    .CLK(clknet_2_2_0_clk));
 sky130_fd_sc_hd__dfxtp_1 _342_ (.D(_042_),
    .Q(ped_s),
    .CLK(clknet_2_2_0_clk));
 sky130_fd_sc_hd__dfxtp_1 _343_ (.D(_043_),
    .Q(ped_d),
    .CLK(clknet_2_2_0_clk));
 sky130_fd_sc_hd__dfxtp_1 _344_ (.D(_044_),
    .Q(\sync_a[0] ),
    .CLK(clknet_2_2_0_clk));
 sky130_fd_sc_hd__dfxtp_1 _345_ (.D(_045_),
    .Q(emg_a_s),
    .CLK(clknet_2_2_0_clk));
 sky130_fd_sc_hd__dfxtp_1 _346_ (.D(_046_),
    .Q(\sync_b[0] ),
    .CLK(clknet_2_2_0_clk));
 sky130_fd_sc_hd__dfxtp_1 _347_ (.D(_047_),
    .Q(emg_b_s),
    .CLK(clknet_2_2_0_clk));
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
 sky130_fd_sc_hd__clkbuf_2 output13 (.A(net13),
    .X(b_yellow));
 sky130_fd_sc_hd__clkbuf_2 output14 (.A(net14),
    .X(ped_walk));
 sky130_fd_sc_hd__clkbuf_16 clkbuf_0_clk (.A(clk),
    .X(clknet_0_clk));
 sky130_fd_sc_hd__clkbuf_1 clkbuf_1_0_0_clk (.A(clknet_0_clk),
    .X(clknet_1_0_0_clk));
 sky130_fd_sc_hd__clkbuf_1 clkbuf_1_1_0_clk (.A(clknet_0_clk),
    .X(clknet_1_1_0_clk));
 sky130_fd_sc_hd__clkbuf_1 clkbuf_2_0_0_clk (.A(clknet_1_0_0_clk),
    .X(clknet_2_0_0_clk));
 sky130_fd_sc_hd__clkbuf_1 clkbuf_2_1_0_clk (.A(clknet_1_0_0_clk),
    .X(clknet_2_1_0_clk));
 sky130_fd_sc_hd__clkbuf_1 clkbuf_2_2_0_clk (.A(clknet_1_1_0_clk),
    .X(clknet_2_2_0_clk));
 sky130_fd_sc_hd__clkbuf_1 clkbuf_2_3_0_clk (.A(clknet_1_1_0_clk),
    .X(clknet_2_3_0_clk));
endmodule
